Bhavay-Sen/Tata/toolchain/driver/ReadMe.txt

MCP_CAN : Is library with Extended frame, Says that there is some problem in silicon with transmitting extended frame.

Using arduino-mcp2515-master as it is tested by me, Multiple times for Standard CAN 2.0A.
