Bhavay-Sen/Tata/Software/TATA_MCU_V.0.3-CODES/TATA_MCU_V.0.3_CODE_V.1.3/readme.txt

  NEW VERSION OF CODE WITH PCB DESIGN V.0.3
  Two Individual NTCs on board.
  Removed Capacitance Measurement
  Added Temperature Data Transmission in CAN Frame ( Revision as per the new Software ICD V._._)

// (Rev 1.2 out of 9.9) -> 1.1 - 1.9 - 2.0 - 9.9(Max)
