Bhavay-Sen/Tata/Software/TATA_MCU_V.0.3-CODES/TATA_MCU_V.0.3_CODE_V.1.1/readme.txt

This is code for MCU V.0.3 - code version V.1.1 includes : 

Voltage Monitoring
Current monitoring
Temperature Monitoring
Charge Calculation 

CAN Communication 

With All the above data in single message + Device Address (0000 - 1111), Code Version (for eg : V.1.1 ~ V101) etc
