Bhavay-Sen/Tata/Documentation/Architecture_HardwareV.0.1.jpg

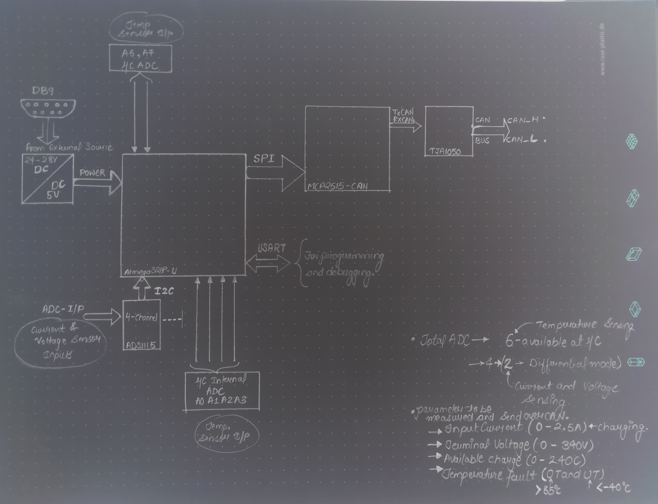
Documentation/Architecture_HardwareV.0.1.jpg
