Bhavay-Sen/Tata/Documentation/inhouse-assembly/3_INHOUSE ASSEMBLY GUIDE FOR TATA340PP40 GUIDELINES.pdf

## IN-HOUSE ASSEMBLY GUIDE FOR TATA340PP40 MCU CARD

Note : This is the document for the components which are marked as DNP in assembly

## AARTECH SOLONICS LIMITED

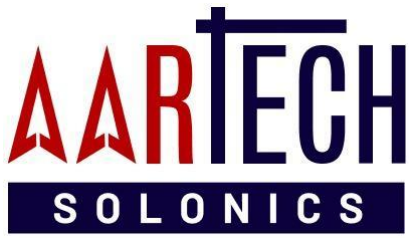
[picture p11: figure]

Document V.0.1

DATE : 27-07-2024

DOCUMENT BY BHAVAY SEN
ASL-240
bsen@aartechsolonics.com | +91-7389901532 | +91-9926316541 | bhavaysen@gmail.com

Component 1 : 16MHz Crystal
Place the component in any orientation, non-polarized component. Please find the position on Y1 near C13.
इस कॉम्पोनेन्ट को कैसेभी लगाया जा सकता है, येनोन - पोलरिज़्ड कॉम्पोनेन्ट है| पीसीबी मेंY1 पर येकॉम्पोनेन्ट सोल्डर होगा, C13 के पास |

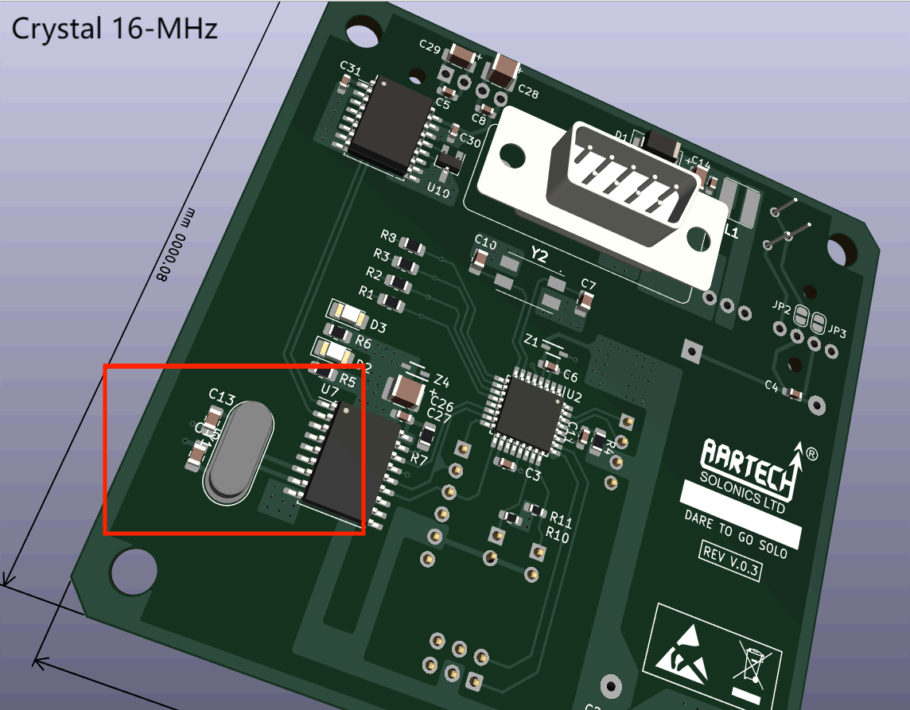
[picture p12: figure]

Component 2 : 6-Pin FRC box header
Place the component at U6, assembly should be done by matching the Pin-1 arrow on the PCB card.
इस कॉम्पोनेन्ट को U6 पर सोल्डर करें, ध्यान देकी येपिन नंबर 1 कॉम्पोनेन्ट की और पीसीबी की मचै हो, जो की एक एरो सेपता चलता है| येएरो कॉम्पोनेन्ट और पीसीबी दोनों परै बना हुआ है

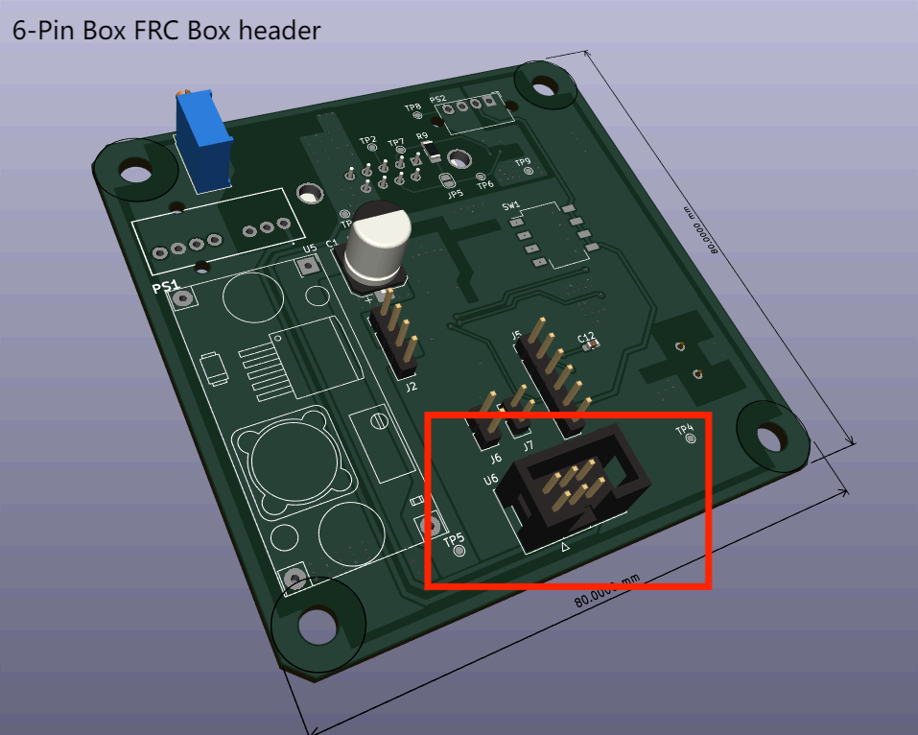
[picture p13: figure]

Component 3 : NTC
Place two NTC’s at J6 and J7 in the PCB. These are non-polarized and can be placed in any orientation. No connector will be used, directly soldered with wires.
एक पीसीबी मेदो NTC लगेंगे, J6 और J7 पर | येनोन - पोलरिज़्ड कॉम्पोनेन्ट है, इसेकिसी
भी ओरिएंटेशन मेंलगाया जा सकता है| TATA340PP40 MCU पीसीबी मेइसेबिना किसी कनेक्टर केसाथ सोल्डर किया जायेगा, इसेडायरेक्ट NTC केवायर्स केसाथ सोल्डर करें|

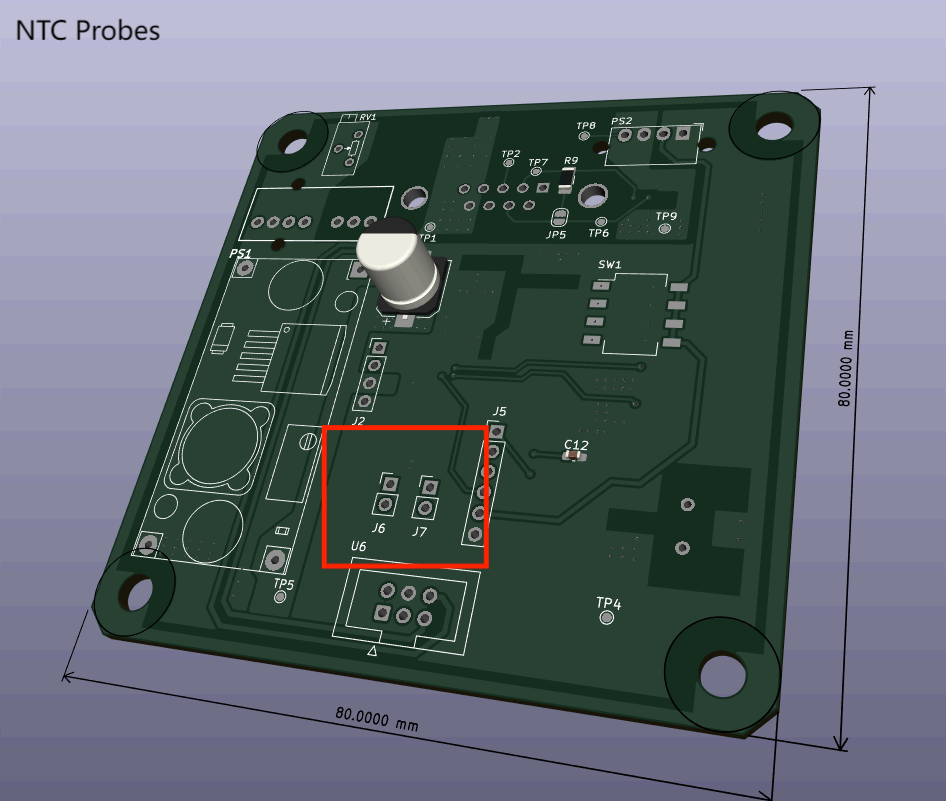
[picture p14: figure]

Component 4 : DC-DC converter (After epoxy)
Place the component at U5 after epoxy, Please check the direction of the placement. Refer to the attached image below. Place the Output side of the Converter at the edge side of the PCB near TP5.
येPower Supply Module है, इस module को U5 पर सोल्डर करे| इस पार्ट को सोल्डर करते वक़्त डायरेक्शन को ध्यान सेदेखे, 5V O/P को TP5 पॉइंट केतरफ सोल्डर करे|

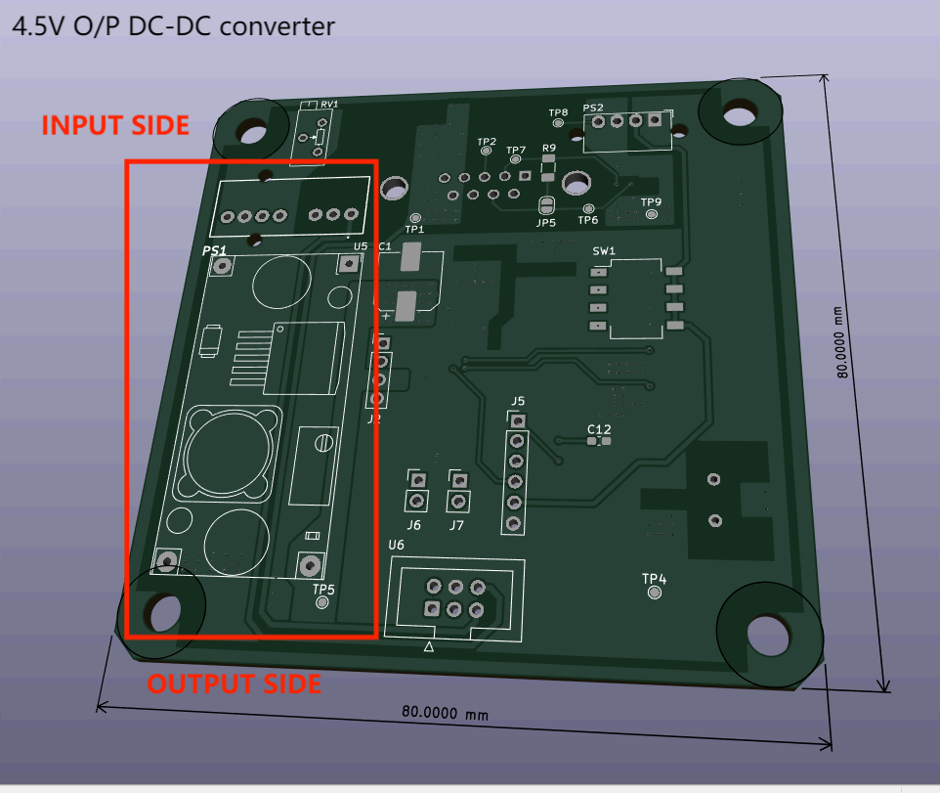
[picture p15: figure]

Component 5 : Solder Jumper JP5
This is the solder jumper not a component, Please connect this jumper with solder fill.
येकिसी प्रकार का कॉम्पोनेन्ट नही है, येएक सोल्डर जम्पर है| पीसीबी मेJP5 पर सोल्डर के सहायता सेइस जम्पर को आपस मेजोड़ दे|

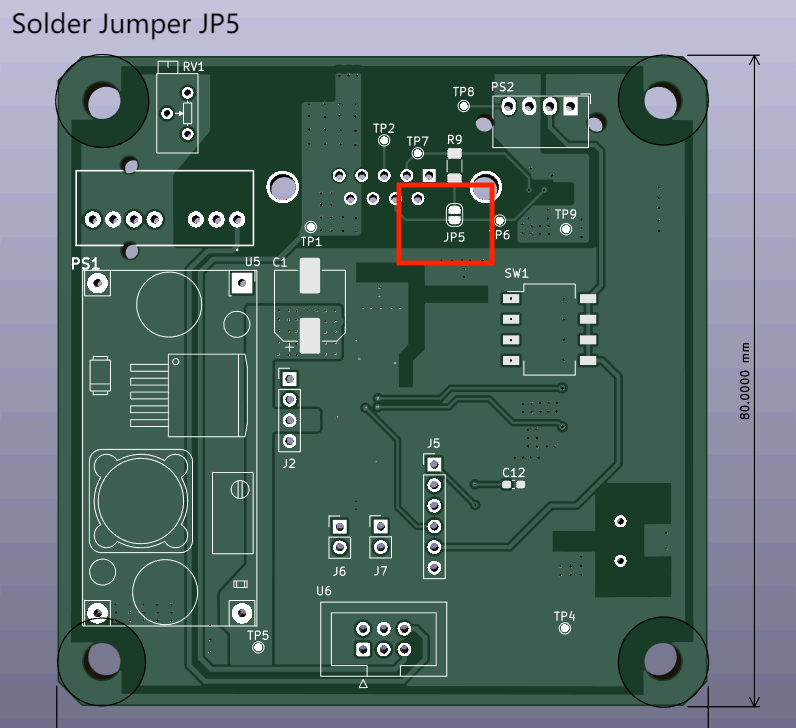
[picture p16: figure]
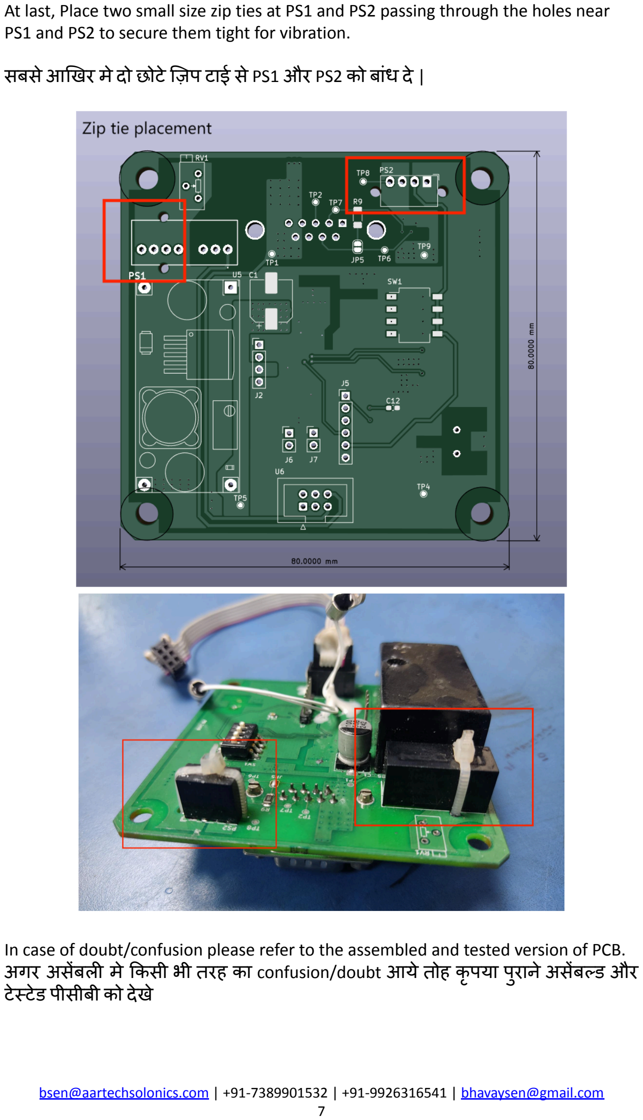
[picture p17: page 7]

At last, Place two small size zip ties at PS1 and PS2 passing through the holes near PS1 and PS2 to secure them tight for vibration.
सबसेआखिर मेदो छोटेज़िप टाई सेPS1 और PS2 को बांध दे|

In case of doubt/confusion please refer to the assembled and tested version of PCB.
अगर असबलें | ी मेकिसी भी तरह का confusion/doubt आयेतोह कृपया परानु ेअसबें | ल्ड और
टेस्टेड पीसीबी को देखे
