Bhavay-Sen/Tata/Software/TATA_MCU_V.0.2-CODES/3. TATA_MCU_V.0.2-SPI_CAN_COMM_TEST-v.0.1/README.txt

arduino-mcp2515-master is the lib file used for CAN Communication.
GITHUB URL : https://github.com/autowp/arduino-mcp2515
