Bhavay-Sen/Tata/Software/TATA_MCU_V.0.2-CODES/2. TATA_MCU_V.0.2-ADC_TEST_CODE-v.0.1/readme.txt

ADC read test code for ADC0, ADC1 and ADC2 is in this file.

Note that the refernce voltage is = Vcc. So the Vcc = Vref = Max resolution that means 0 - 1023 -> 0V t0 Vcc (4.5, 4.7, 5.0)
