Bhavay-Sen/Tata/Software/TATA_MCU_V.0.2-CODES/1. TATA_MCU_V.0.2-IO_TEST_CODE-v.0.1/README.txt

1. GPIO to test :
	A. Two LED's at PD3 and PD4 (uC) and Arduino -> Pin 3 and 4.
	B. Device Address I/O by DIP switch, PD5, PD6, PD7, PB0 (uC) and Arduino -> Pin 5, 6, 7, 8.
2. Data at serial.

LEDs will glow on the board and Device pin data by dip switch will be read and print on the serial.
