Bhavay-Sen/Tata/Documentation/Flow of process (TATA_340PP40) V.0.1 .pdf

# TATA340PP40 Flow of process

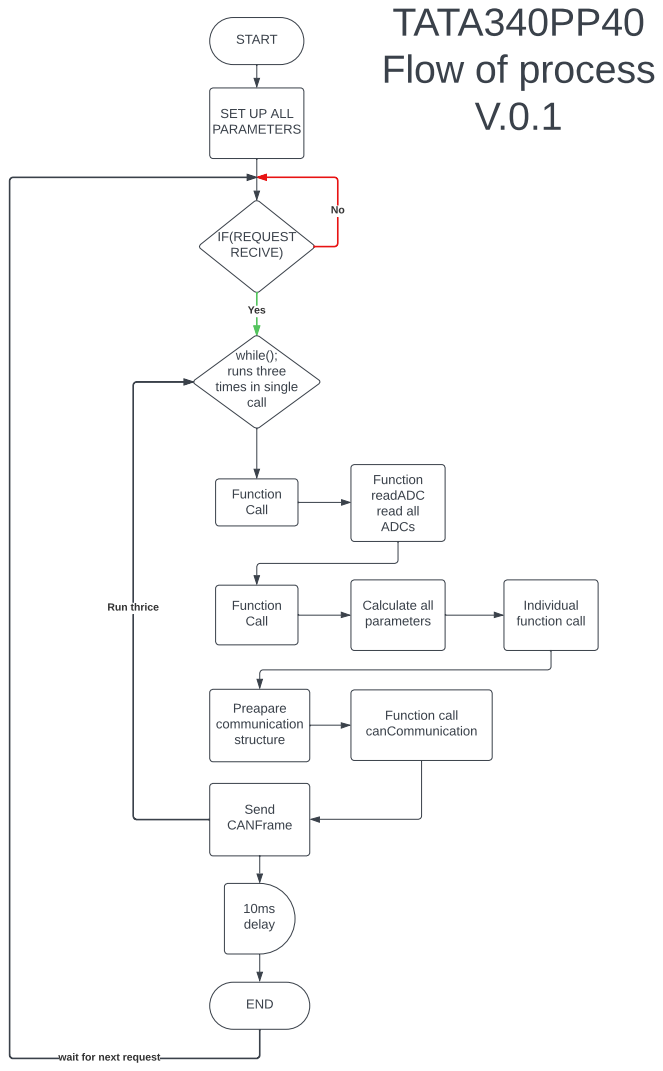
[picture p31: page 1]
START; IF(REQUEST RECIVE); Yes; Function Call; Function readADC read all ADCs; Calculate all parameters; Individual function call; Preapare communication structure; Function call canCommunication; Send CANFrame; Run thrice; END; 10ms delay

SET UP ALL
PARAMETERS

while();
runs three
times in single
call

wait for next request
