Bhavay-Sen/Tata/Documentation/TATA-MCU-CAN FLOW V.1.2.pdf

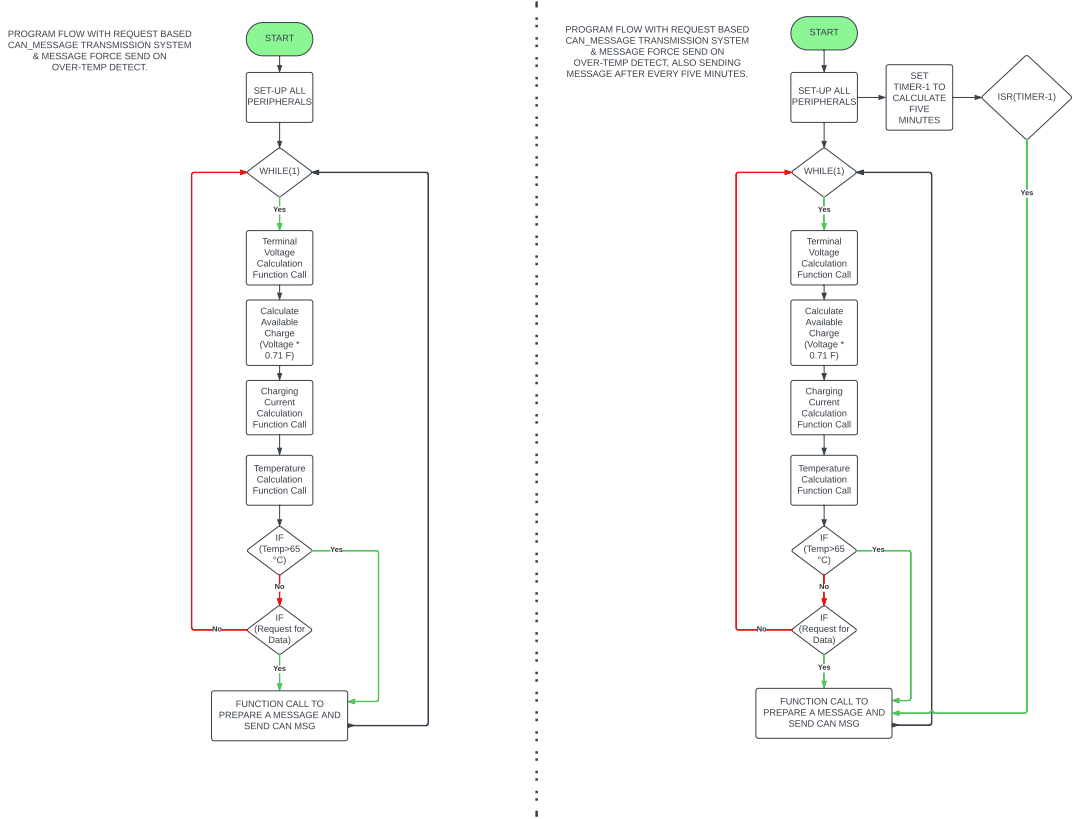
[picture p32: page 1]
START; WHILE(1); Yes; (Voltage * 0.71 F); IF (Temp>65 °C); MESSAGE AFTER EVERY FIVE MINUTES.; SET; TIMER-1 TO CALCULATE FIVE MINUTES; ISR(TIMER-1)

PROGRAM FLOW WITH REQUEST BASED
CAN_MESSAGE TRANSMISSION SYSTEM
& MESSAGE FORCE SEND ON
OVER-TEMP DETECT, ALSO SENDING

OVER-TEMP DETECT.

SET-UP ALL
PERIPHERALS

Terminal
Voltage Calculation Function Call

Calculate Available Charge

Charging
Current
Calculation Function Call

Temperature Calculation Function Call

(Request for Data)

FUNCTION CALL TO
PREPARE A MESSAGE AND
SEND CAN MSG
