Bhavay-Sen/Tata/(commit log)

2024-08-06 Upadated code and tested individual code for CAN read, current sensing and Functional test on CAN
2024-08-06 Earlier version of MCU_V.0.1 have been identified with major issues of isoation other problems, new hardware is designed MCU_V.0.2. leaving behind Code version V.0.1, only taking up MCP2515 CAN driver
    [IO_TEST_WITH_SERIAL.ino]
2024-08-06 Added SPI-CAN Communication test code
2024-08-06 Added sensor testing codes in TATA_MCU_V.0.2-TEST_CODES, 4. Current sensing module - ACS712 5. Voltage sensing module VH1k0t01 sensor 6. Temperature sensing module for USP10976 7. 4-bit dip switch ad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
2024-08-08 This is code for MCU V.0.3 - code version V.1.1 includes :
    Voltage Monitoring
    Current monitoring
    Temperature Monitoring
    Charge Calculation
    CAN Communication With All the above data in single message + Device Address (0000 - 1111), Code Version (for eg : V.1.1 ~ V101) etc
2024-08-08 Added V.1.2 code version in TATA MCU V.0.3 CODES. This code is based on the updated flow of process verified by AGG, Added : 1. DIP switch based device addressing module. 2. Over-Temperature detect, 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
    [TATA_MCU_V.0.3_CODE_V.1.2.ino]
2024-08-08 Version 1.3 added in V.0.3 CODES, NEW VERSION OF CODE WITH PCB DESIGN V.0.3 Two Individual NTCs on board. Removed Capacitance Measurement Added Temperature Data Transmission in CAN Frame ( Revision a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
2024-08-08 Updated Code V.1.3, Committing V.1.3. Added in MCU V.0.3 CODES. Changed the Over-Temperature fault mechanisim ALGO : if(OT detected){ send Message without request then, Turn on timer 1 in CTC mode fo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
    [TATA_MCU_V.0.3_CODE_V.1.4.ino]
2024-08-10 Changed the Over-Temperature fault mechanisim ALGO : if(OT detected){ send Message without request then, Turn on timer 1 in CTC mode for 3 sec then, at ISR for comp A, Turn off timer 1 , reset the ch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
    [TATA_MCU_V.0.3_CODE_V.1.4.ino]
2024-08-10 "This is the final version of code for MCU V.0.3 and UCAP board with ACS712 Hall effect sensor. below changes are made in the code after V.1.3. 1. Changed the over-temperature fault mechanism 2. Now 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
2024-08-10 Updated code for MCU V.0.3 Code version 1.5 for new UCAP PCB with HET055T01 UCAP PCB V2.0
2024-08-12 Added documents and drivers required
2024-08-27 Added Testing codes, Added blink of LED on msg send
