Bhavay-Sen/Tata/Hardware/mcu_board_images/MCU_CARD_V.0.2.jpg

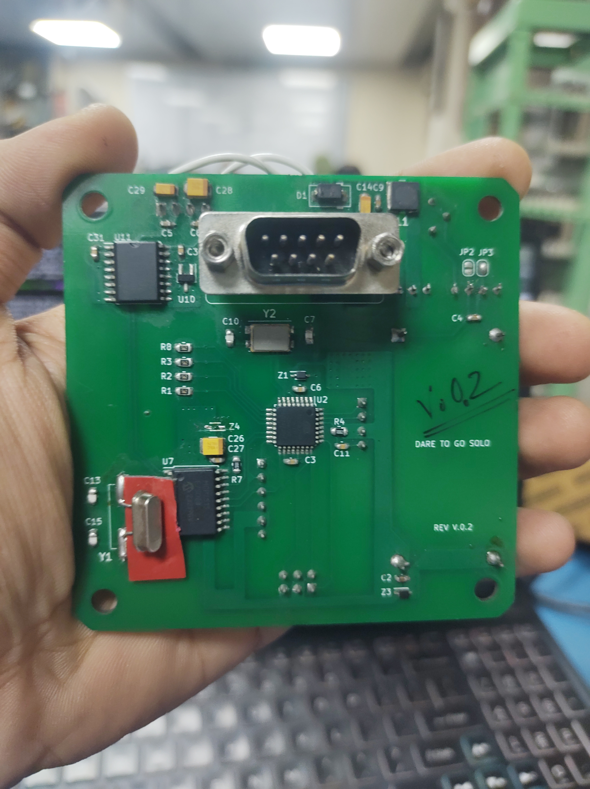
[picture p2: Hardware/mcu_board_images/MCU_CARD_V.0.2.jpg]
Hardware/mcu_board_images/MCU_CARD_V.0.2.jpg
