Bhavay-Sen/Tata/Hardware/mcu_board_images/MCU_CARD_V.0.3.jpg

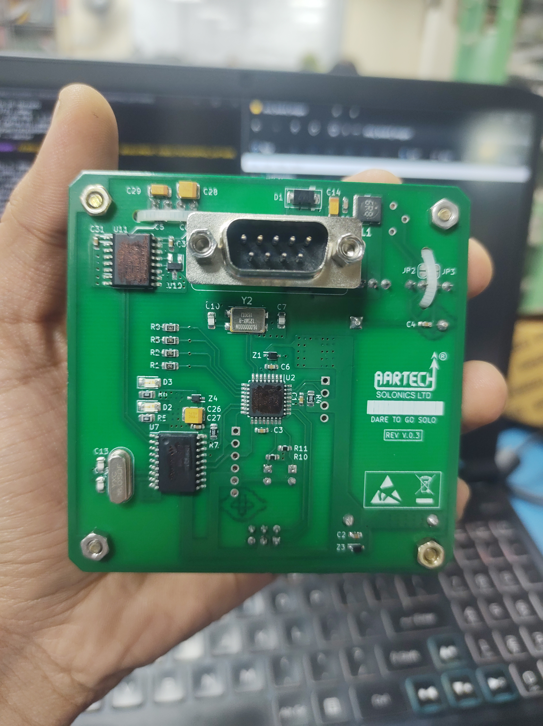
[picture p3: Hardware/mcu_board_images/MCU_CARD_V.0.3.jpg]
Hardware/mcu_board_images/MCU_CARD_V.0.3.jpg
